wemperor/SPECY/README.md

# SPECY
SPECY - Arduino and Ocean Optics STS Spectrometer 

www.specy.de

Specy is a small and simple spectroscopy system that relies on the Ocean Optics STS spectrometer module and Arduino based open source hardware. The system is small, lightweight and consumes a minimum of energy. Further it is fully autonomous and basically will consequently measure hyperspectral data to SD card once it´s activated.
The firmware of Specy is easy to understand and written in Arduino which allows to freely adapt the base code to specific needs. Adaptations of Specy have been used on UAVs, Tractors, in various lab application and as field instrument.



Have a look in the documentation PDF for details on components and assembly.

Copyright (c) 2016, Forschungszentrum Jülich GmbH
All rights reserved.
Contributors: Andreas Burkart
Address: Institute of Bio- and Geosciences, Plant Sciences (IBG-2), Forschungszentrum Jülich GmbH, 52428 Jülich, Germany

Specy Firmware ist licensed unter the following BSD 3-Clause License - See License for Details
