wemperor/SPECY/(threads)

Thread 2 (2018-11-26):

cannot get operational

CHNapier2112, 2018-11-26:
Hello,
We are a NASA payload team from College of the Canyons in California that came across your remote spectrometer system and would wonder if you could provide us any assistance.
We attempted last year to use spectrometer data to measure stratospheric acid levels on board a high altitude weather balloon, but we unsuccessful getting coding for the spectrometer, an ocean optics STS VIS. We believe your system would prove very beneficial to the project, and would enjoy collaborating with you if possible as we have been unable to get the SPECY code to work on our end.
Any help or advice would be greatly appreciated.
Thank you,
-Hunter Napier

wemperor, 2018-11-26:
Hi,
of cause it´s no problem to help you out.
But would be useful to have some idea where your problem is located, either on the hardware or firmware side. You can directly email me via wemperor at gmail dot com

Best,
Andreas

reboottq, 2019-10-20:
Hello, I am a student from China. Recently I was doing some experiments with STS-VIS and Arduino, and I used your code as a reference, but I can't read the data, so I would like to ask you some questions. Is the address in the function and the number of sensors in sts_get_temp()  need changed? thank you very much!

Thread 3 (2019-10-20):

Some questions about STS-VIS and arduino

reboottq, 2019-10-20:
Hello, I am a student from China. Recently I was doing some experiments with STS-VIS and Arduino, and I used your code as a reference, but I can't read the data, so I would like to ask you some questions. Is the address in the function and the number of sensors in sts_get_temp()  need changed? thank you very much!

wemperor, 2019-10-21:
The code should run right away if the wiring is right. Please check your
wiring and especially if the STS status LED blinks on a measurement.

Am So., 20. Okt. 2019 um 15:39 Uhr schrieb reboottq <
notifications@github.com>:

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

Zainraza024, 2020-10-22:
Hi I am trying to set up RTC time and date i used various tutorials but after setting it up when i connect it with my specy again it does not show any time it always starts from 00:00:00 and the folder is saved with 000000,000001

Thread 6 (2020-10-26):

Data not writing

Zainraza024, 2020-10-26:
[
Hi ,
I am working on Specy project. I really appriciate the work you have done.
i am using your code all the connection and wiring is fine but the problem is that the file is created in D card without the data. I have attached screen shot of the file with size 0 kb. if you see the file name is also not correct.

SDcard = SD.open(current_file_name, O_CREAT | O_WRITE)  is not saving the the data.
 I hope you pplease help me that
Thankyou

does something need to be change in the code
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

](url)
